gabrielseibel1/QuanserControllerShield/README.md

# QuanserControllerShield
QCS (Quanser Controller Shield) is a project of a PCB that controls the Quanser robot arm. 
Based on a Galileo Gen 2 board, a quadrature decoder and and H-bridge.

## Compilation
Executing the following commands, the library and the test script binaries 
should be generated.

    $ mkdir build
    $ cd build
    $ cmake ..
    $ make
