gabrielseibel1/QuanserControllerShield/doc/latex/md__home_gabriel_CLionProjects_QuanserControllerShield_README.tex

Q\+CS (Quanser Controller Shield) is a project of a P\+CB that controls the Quanser robot arm. Based on a Galileo Gen 2 board, a quadrature decoder and and H-\/bridge.

\subsection*{Compilation}

Executing the following commands, the library and the test script binaries should be generated. \begin{DoxyVerb}$ mkdir build
$ cd build
$ cmake ..
$ make\end{DoxyVerb}
