gabrielseibel1/QuanserControllerShield/pcb/inverter/inverter.BMP

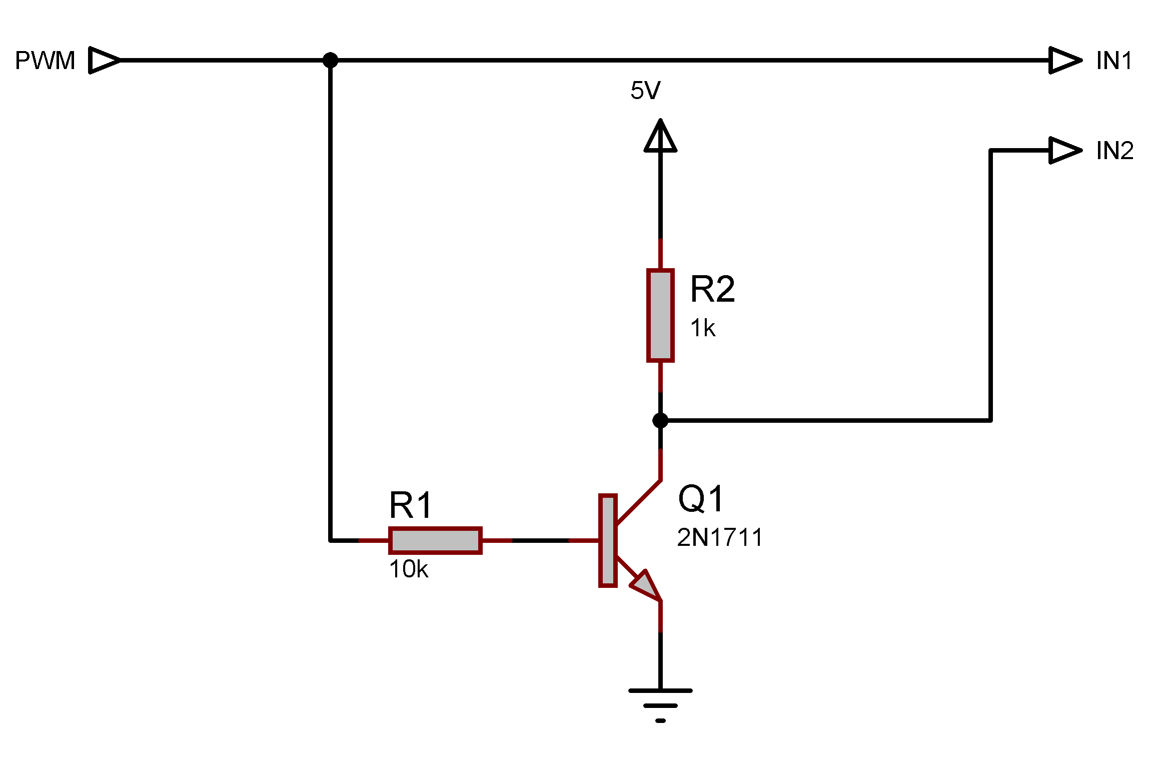
pcb/inverter/inverter.BMP
