gabrielseibel1/QuanserControllerShield/pcb/QuanserControllerShield_schematic.PDF

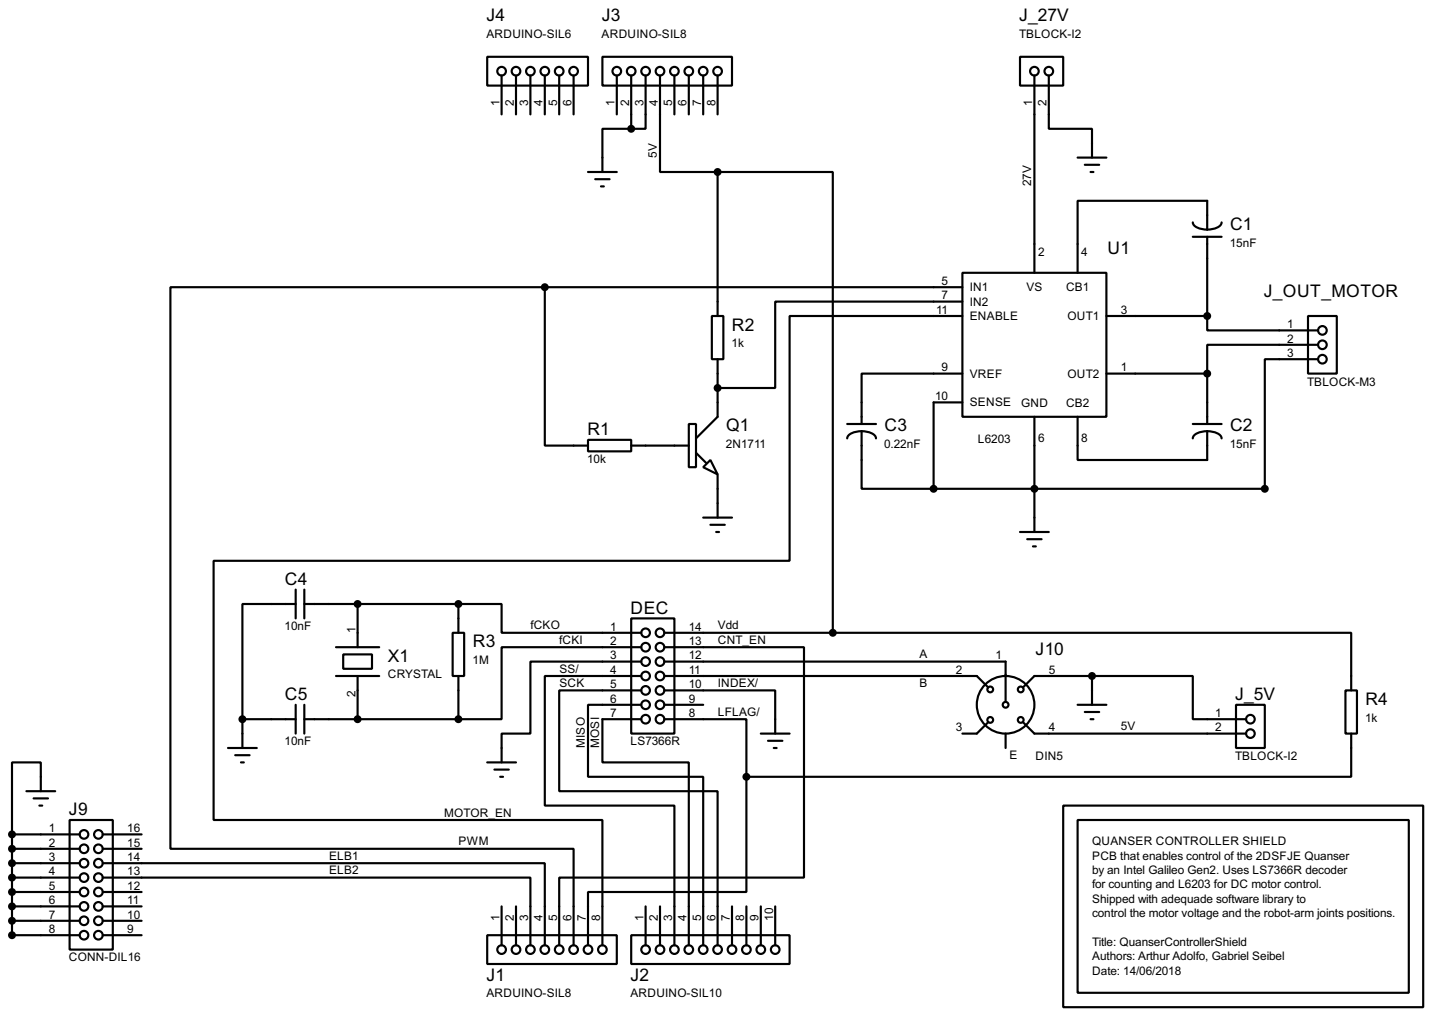
[picture p17: page 1]

fCKO
SS/ | | 3 | | CNT_EN 12

4 | | 11 | | 2
5 | | INDEX/ 10
6 | | 9 | | LFLAG/

QUANSER CONTROLLER SHIELD
PCB that enables control of the 2DSFJE Quanser by an Intel Galileo Gen2. Uses LS7366R decoder

for counting and L6203 for DC motor control. Shipped with adequade software library to

control the motor voltage and the robot-arm joints positions. Title: QuanserControllerShield Authors: Arthur Adolfo, Gabriel Seibel Date: 14/06/2018
