gabrielseibel1/QuanserControllerShield/pcb/QuanserControllerShield_bottom.PDF

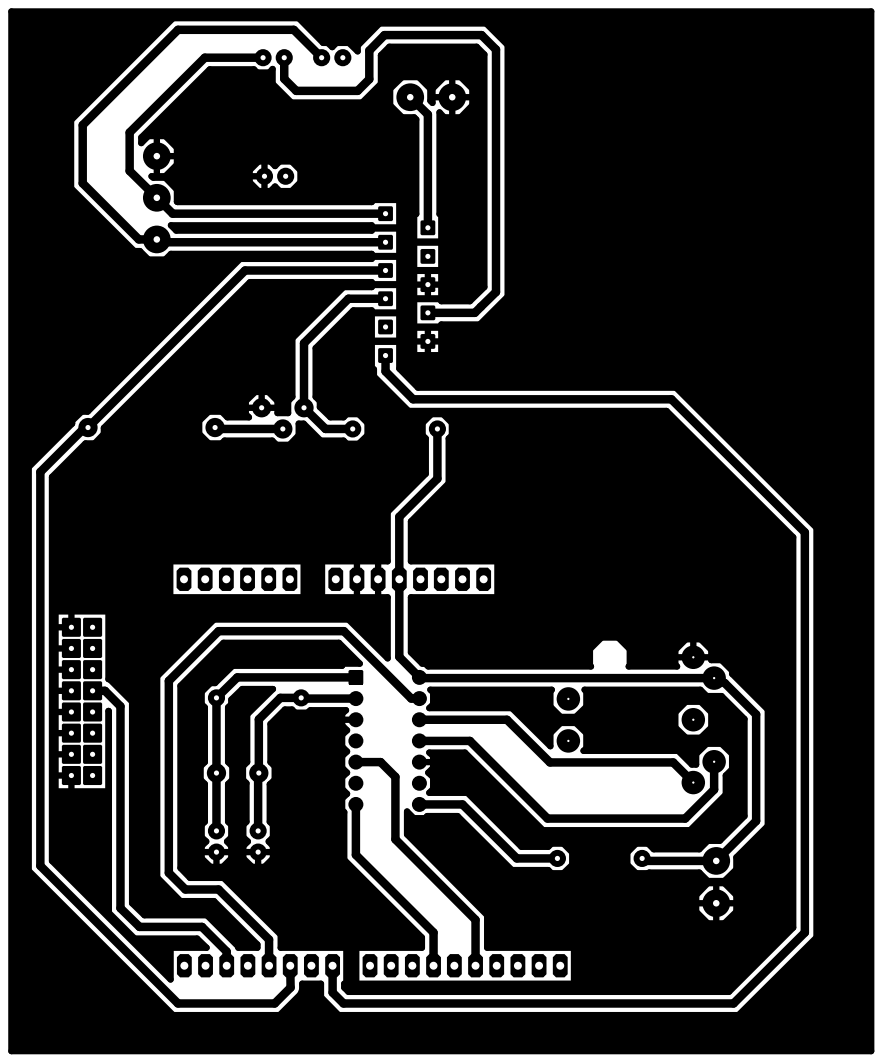
[picture p18: page 1]
