gabrielseibel1/QuanserControllerShield/pcb/QuanserControllerShield_top.PDF

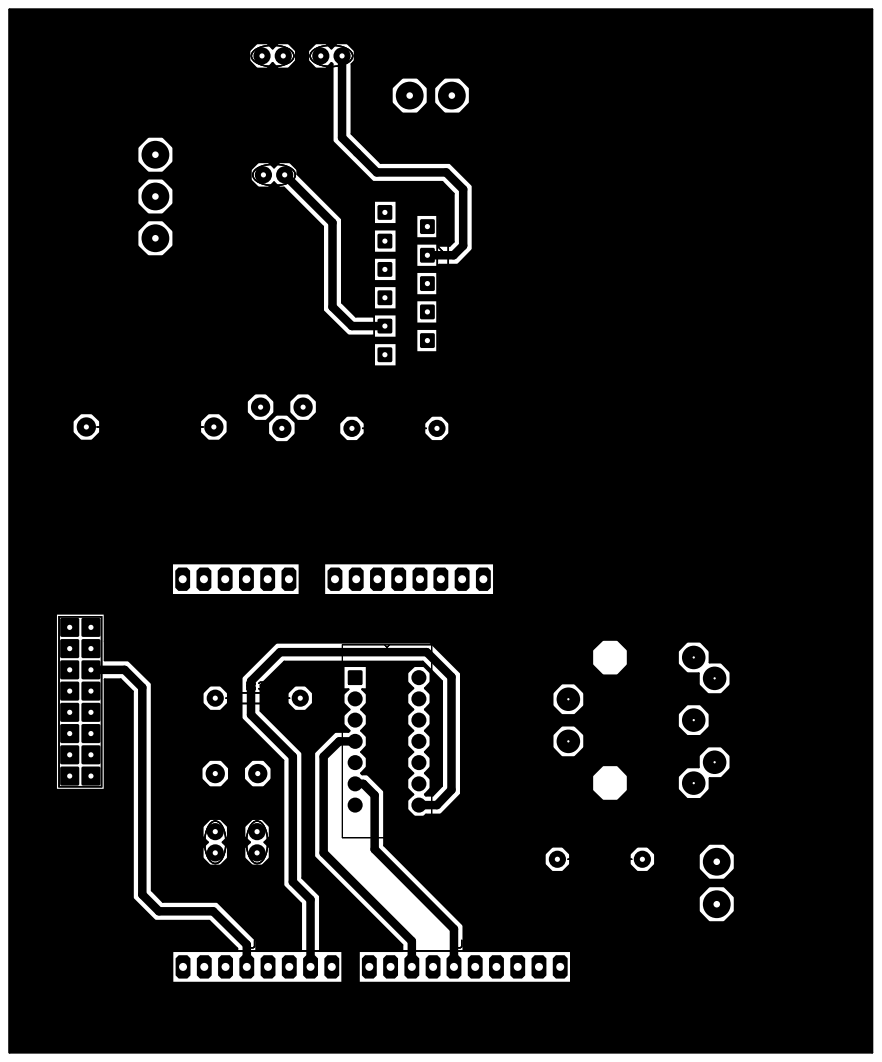
[picture p19: page 1]
