gabrielseibel1/QuanserControllerShield/(list of files, drawings)

Other design files:
pcb/decoder/decoder.pdsprj
pcb/h-bridge/hbridge.pdsprj
pcb/inverter/inverter.pdsprj
pcb/microswitch/microswitch.pdsprj
pcb/QuanserControllerShield.pdsprj
