gabrielseibel1/QuanserControllerShield/src/QuanserControllerShield.h

//
// Declarations for Quanser-Controller Shield (high level abstraction of the board)
//

#ifndef QUANSERCONTROLLERSHIELD_QUANSERCONTROLLERSHIELD_H
#define QUANSERCONTROLLERSHIELD_QUANSERCONTROLLERSHIELD_H

#include "../include/Motor.h"
#include "../include/Decoder.h"
#include "../include/MicroSwitches.h"

class QuanserControllerShield {
public:
    Motor *motor;
    Decoder *decoder;
    MicroSwitches *microSwitches;

    /**
     * Initializes all the components, opening and configuring necessary files
     */
    QuanserControllerShield();

    /**
     * Destroys all the components, configuring and closing necessary files
     */
    virtual ~QuanserControllerShield();
};

#endif //QUANSERCONTROLLERSHIELD_QUANSERCONTROLLERSHIELD_H
