gabrielseibel1/QuanserControllerShield/src/QuanserControllerShield.cpp

//
// Declarations for Quanser-Controller Shield (high level abstraction of the board)
//

#include "QuanserControllerShield.h"

QuanserControllerShield::QuanserControllerShield() = default;

QuanserControllerShield::~QuanserControllerShield() = default;
