gabrielseibel1/QuanserControllerShield/include/galileo2io.h

/*
  galileo2io.h: Helper functions for Galileo I/O

  Copyright (c) 2016 Walter Fetter Lages <w.fetter@ieee.org>

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
    You can also obtain a copy of the GNU General Public License
    at <http://www.gnu.org/licenses>.

*/

/* USED BY ARTHUR ADOLFO E GABRIEL DE SOUZA SEIBEL */

#ifndef GALILEO2IO_H
#define GALILEO2IO_H

extern char *pgets(char *s, int size, const char path[]);

extern int pputs(const char path[], const char s[]);

#endif
