gabrielseibel1/QuanserControllerShield/(commit log)

2018-06-22 Add proteus files
    [micros.pdsprj]
2018-06-23 placement and routing
    [micros.pdsprj]
2018-06-23 Less ocuppied space
    [micros.pdsprj]
2018-06-23 Add two faces
    [micros.pdsprj]
2018-06-24 Adjust pcb
    [micros.pdsprj]
2018-06-26 Fix isolations
    [micros.pdsprj]
2018-06-28 Fix position shield connectors
    [micros.pdsprj]
2018-06-29 Add sensor fim de curso program
2018-06-30 Read switches separately and add .h
2018-06-30 Move micro switch header to /include
2018-06-30 Change micro switch files description
2018-06-30 Change switch reading from int to char
2018-06-30 Add files for motor actuation
2018-07-02 Make micro switches object oriented
2018-07-02 Make motor object oriented
2018-07-02 Enhance error detection and implement motor enable/disable
    [Motor.h]
2018-07-02 Change PWM frequency to 1KHz
2018-07-02 Document and organize files
    [micros.pdsprj]
2018-07-04 Add documentation
    [QuanserControllerShield.SDF, QuanserControllerShield.pdsprj, decoder.pdsprj, hbridge.pdsprj, inverter.pdsprj, micros.pdsprj, microswitch.pdsprj]
2018-07-04 Regenerate bom, gerbers, schems and layers
    [QuanserControllerShield.SDF]
2018-07-04 Fix static library linking
    [test.cpp]
2018-07-04 Implement PID controller
2018-07-04 Add pid controller
2018-07-04 Add pwm test script
2018-07-04 Add pwm test script make
2018-07-04 Add decoder test and fix pins
    [decoder_test.cpp]
